luizopiloto/gameport_flightstick/README.md

# gameport_flightstick
An overengineered gameport compatible flightstick for Retro PCs.

As it becomes more and more hard to find good and reliable gameport 
joysticks/flightsticks to play those old games on original hardware, 
I tried to make my own gameport joystick that uses hall effect sensors 
instead of those unreliable potentiometers.

The circuit makes use of MCP41100 ICs to replace the 100K potentiometers. 

The microcontroler (Arduino Nano v3) takes care of noise reduction
adds a "cubic curve" to smooth the input.

To activate calibration mode, press and hold all the 4 buttons untill
the joystick input starts to flicker, something around 10 seconds. 
Release the buttons and move all the 4 axis to it's maximun and minimun positions.
To save the calibration press button 3 + button 4.
To cancel press button 1 + button 2.
<p align="center">
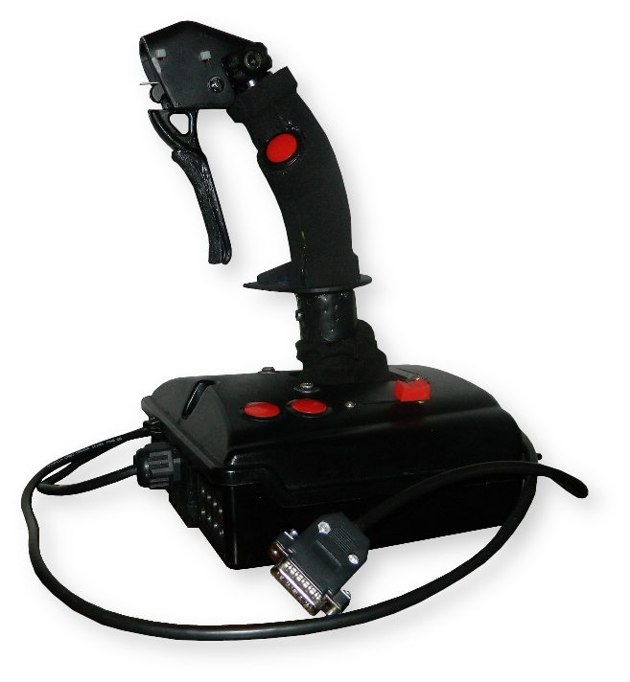
[picture p1: flightstick.png]
Flightstick
  
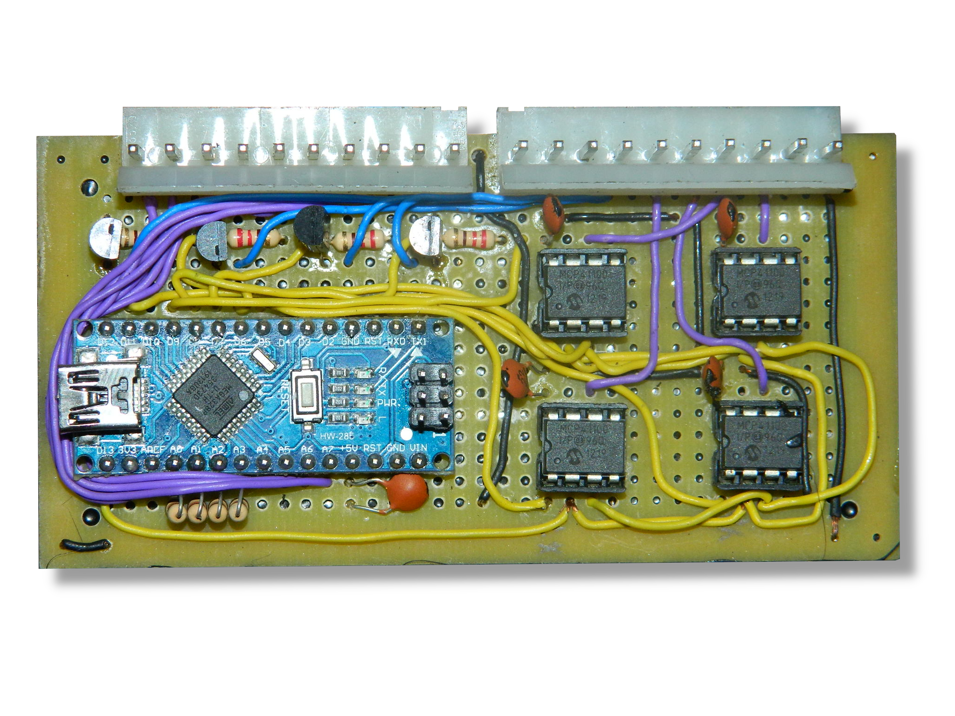
[picture p2: circuit_board.png]
Circuit Board
  
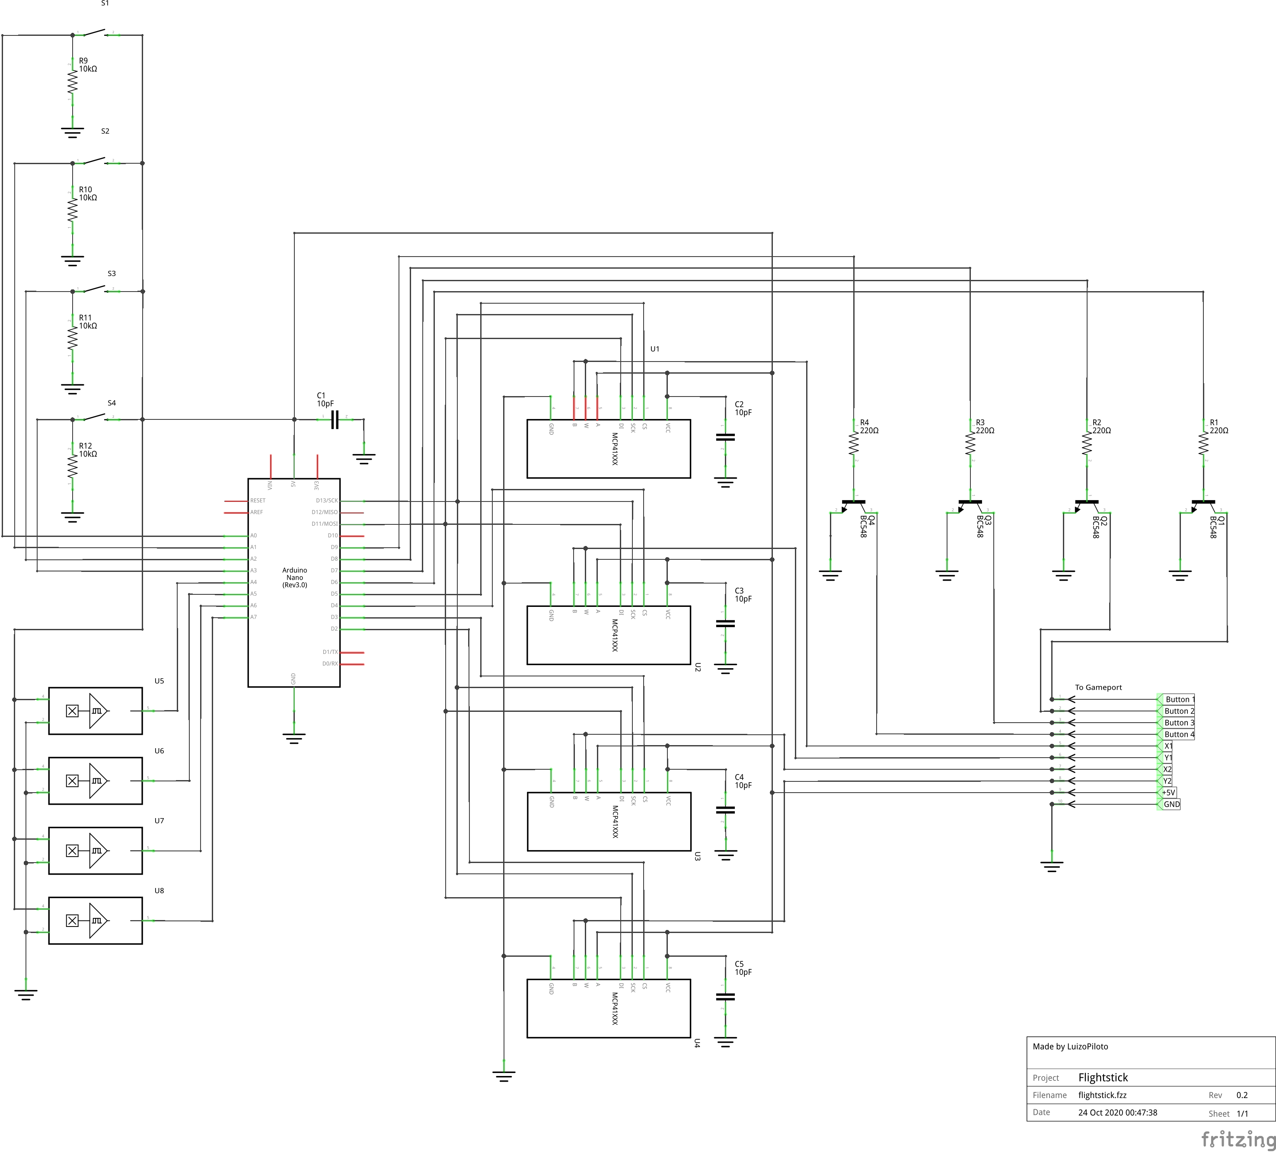
[picture p3: flightstick_schem.png]
Circuit Diagram
  
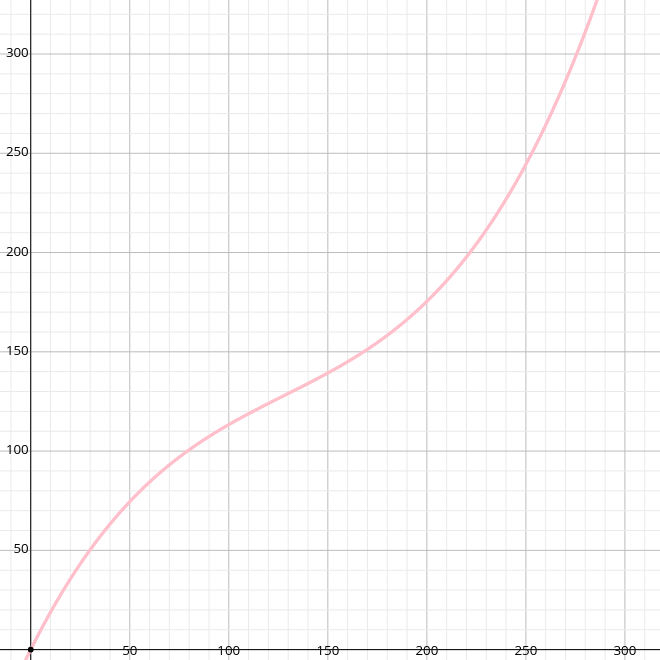
[picture p4: graph_plot.png]
Axis Graph Plot
  
</p>
